feshie/ms1/SystemBlock.png

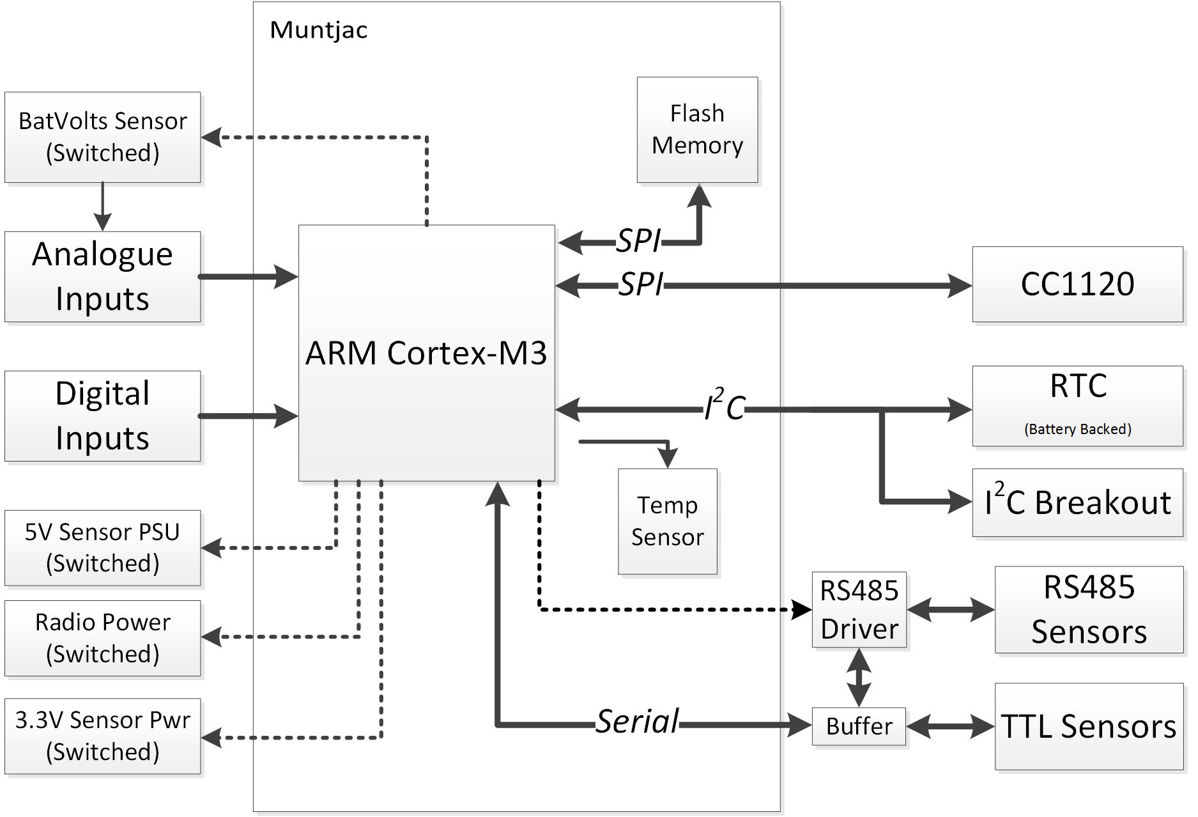
SystemBlock.png
