feshie/ms1/ms1.brd

## EAGLE design ms1.brd (2014-09-29)

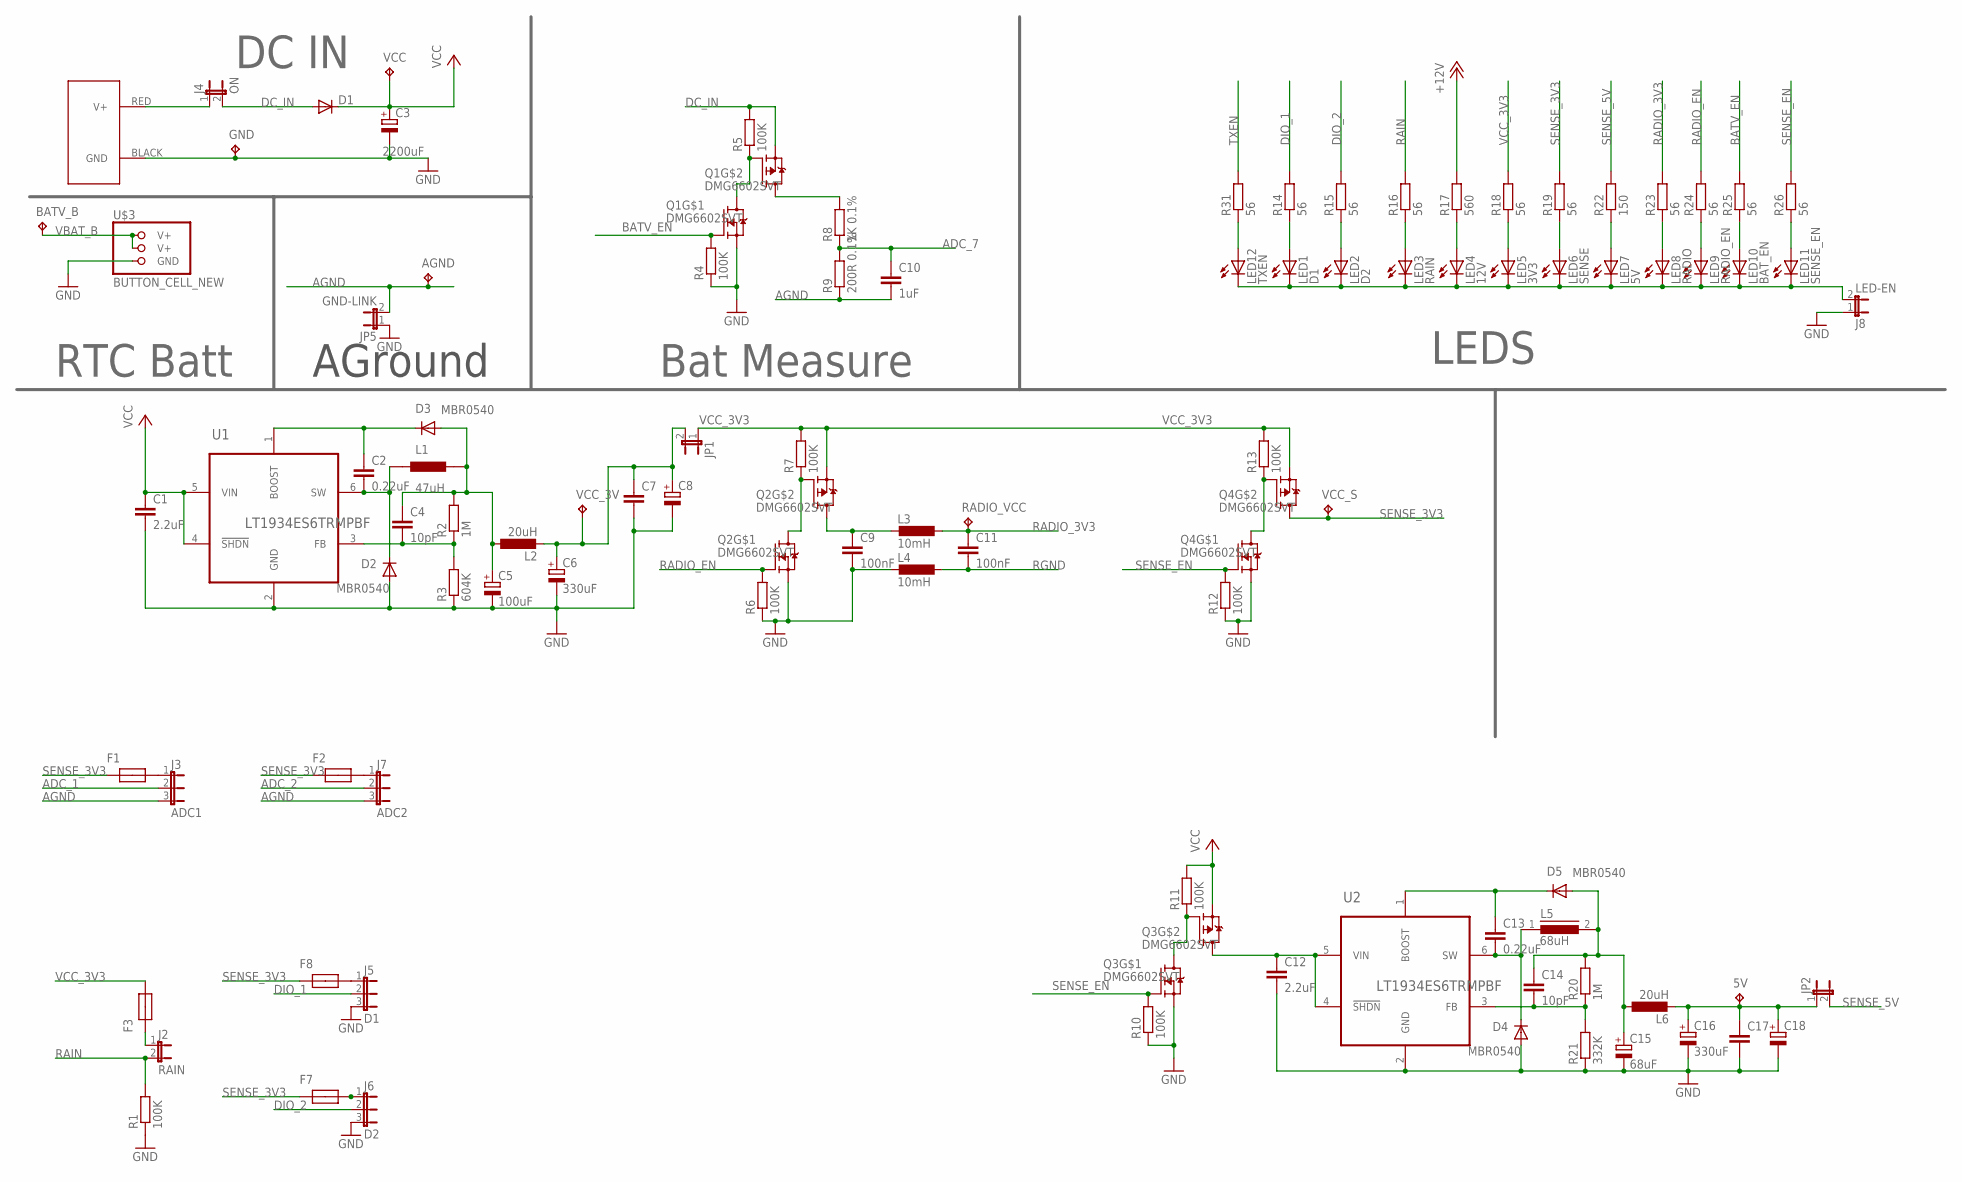
[picture p2: schematic ms1.sch, sheet 1, Power]

Parts:
5V: 5V B; B2,54
AGND: TPB2,54; B2,54
BATV_B: 5V B; B2,54
C1, C12: 2.2uF; C0805
C2, C13: 0.22uF; C0805
C3: 2200uF; E5-13
C4, C14: 10pF; C0805
C5: 100uF; PANASONIC_E
C6, C16: 330uF; E5-8,5
C7, C17: C-EUC0805; C0805
C8, C18: CPOL-EUB/3528-21R; B/3528-21R
C9, C11: 100nF; C0805
C10: 1uF; C0805
C15: 68uF; PANASONIC_E
D1: DIODE-SMB; SMB
D2, D3, D4, D5: MBR0540; SOD123
F1, F2, F3, F7, F8: MCF0805; 0805
GND: 5V B; B2,54
J1: POWERPOLE_POWER25A; POWERPOLE_PAIR_25A
J2: RAIN; 2-MOLEX
J3: ADC1; 3-MOLEX
J4: ON; 2-MOLEX
J5: D1; 3-MOLEX
J6: D2; 3-MOLEX
J7: ADC2; 3-MOLEX
J8: LED-EN; 2-MOLEX
JP1, JP2: JUMPER-2SMD-NO; SJ_2S-NO
JP5: GND-LINK; JP1
L1: 47uH; 1048
L2, L6: 20uH; 6000-XXXX-RC
L3, L4: 10mH; L3230M
L5: 68uH; DR127
LED1: D1; CHIP-LED0805
LED2: D2; CHIP-LED0805
LED3: RAIN; CHIP-LED0805
LED4: 12V; CHIP-LED0805
LED5: 3V3; CHIP-LED0805
LED6: SENSE; CHIP-LED0805
LED7: 5V; CHIP-LED0805
LED8: RADIO; CHIP-LED0805
LED9: RADIO_EN; CHIP-LED0805
LED10: BAT_EN; CHIP-LED0805
LED11: SENSE_EN; CHIP-LED0805
LED12: TXEN; CHIP-LED0805
Q1, Q2, Q3, Q4: DMG6602SVT; TSOT26
R1, R4, R5, R6, R7, R10, R11, R12, R13: 100K; R0805
R2, R20: 1M; R0805
R3: 604K; R0805
R8: 1K 0.1%; R0805
R9: 200R 0.1%; R0805
R14, R15, R16, R18, R19, R23, R24, R25, R26, R31: 56; R0805
R17: 560; R0805
R21: 332K; R0805
R22: 150; R0805
RADIO_VCC: TPB2,54; B2,54
U1, U2: LT1934ES6TRMPBF; SOT95P280X100-6N
U$3: BUTTON_CELL_NEW; CR2016
VCC: TPB2,54; B2,54
VCC_3V: TPB2,54; B2,54
VCC_S: TPB2,54; B2,54

Connections:
ADC_1: J3.2; also elsewhere on the board
ADC_2: J7.2; also elsewhere on the board
ADC_7: C10.1, R8.1, R9.2; also elsewhere on the board
AGND: AGND.TP, C10.2, J3.3, J7.3, JP5.2, R9.1; also elsewhere on the board
BATV_EN: Q1.P$1 (G), R4.2, R25.2; also elsewhere on the board
DC_IN: D1.A, J4.2, Q1.P$2 (S), R5.2
DIO_1: J5.2, R14.2; also elsewhere on the board
DIO_2: J6.2, R15.2; also elsewhere on the board
GND: C1.2, C3.-, C5.-, C6.-, C7.2, C8.-, C9.2, C12.2, C15.-, C16.-, C17.2, C18.-, D2.A, D4.A, GND.TP, J1.BLACK (GND), J5.3, J6.3, J8.1, JP5.1, L4.2, Q1.P$5 (S), Q2.P$5 (S), Q3.P$5 (S), Q4.P$5 (S), R1.1, R3.1, R4.1, R6.1, R10.1, R12.1, R21.1, U1.2 (GND), U2.2 (GND), U$3.GND; also elsewhere on the board
LGND: J8.2, LED1.C, LED2.C, LED3.C, LED4.C, LED5.C, LED6.C, LED7.C, LED8.C, LED9.C, LED10.C, LED11.C, LED12.C
unnamed: J1.RED (V+), J4.1
unnamed: LED4.A, R17.1
unnamed: C13.2, D4.C, L5.1, U2.6 (SW)
unnamed: C13.1, D5.C, U2.1 (BOOST)
unnamed: C14.2, R20.1, R21.2, U2.3 (FB)
unnamed: C14.1, C15.+, D5.A, L5.2, L6.1, R20.2
unnamed: Q2.P$3 (G), Q2.P$6 (D), R7.1
unnamed: Q1.P$3 (G), Q1.P$6 (D), R5.1
unnamed: C6.+, C7.1, C8.+, JP1.2, L2.2, VCC_3V.TP
unnamed: 5V.TP, C16.+, C17.1, C18.+, JP2.1, L6.2
unnamed: LED9.A, R24.1
unnamed: LED3.A, R16.1
unnamed: F1.2, J3.1
unnamed: F2.2, J7.1
unnamed: LED2.A, R15.1
unnamed: F7.2, J6.1
unnamed: F8.2, J5.1
unnamed: LED1.A, R14.1
unnamed: C9.1, L3.2, Q2.P$4 (D)
unnamed: Q3.P$3 (G), Q3.P$6 (D), R11.1
unnamed: F3.1, J2.1
unnamed: LED12.A, R31.1
unnamed: LED10.A, R25.1
unnamed: LED11.A, R26.1
unnamed: Q4.P$3 (G), Q4.P$6 (D), R13.1
unnamed: C2.2, D2.C, L1.1, U1.6 (SW)
unnamed: C4.1, C5.+, D3.A, L1.2, L2.1, R2.2
unnamed: LED8.A, R23.1
unnamed: LED7.A, R22.1
unnamed: LED6.A, R19.1
unnamed: LED5.A, R18.1
unnamed: C2.1, D3.C, U1.1 (BOOST)
unnamed: C4.2, R2.1, R3.2, U1.3 (FB)
RADIO_3V3: C11.1, L3.1, R23.2, RADIO_VCC.TP; also elsewhere on the board
RADIO_EN: Q2.P$1 (G), R6.2, R24.2; also elsewhere on the board
RAIN: J2.2, R1.2, R16.2; also elsewhere on the board
RGND: C11.2, L4.1; also elsewhere on the board
SENSE_3V3: F1.1, F2.1, F7.1, F8.1, Q4.P$4 (D), R19.2, VCC_S.TP; also elsewhere on the board
SENSE_5V: JP2.2, R22.2; also elsewhere on the board
SENSE_EN: Q3.P$1 (G), Q4.P$1 (G), R10.2, R12.2, R26.2; also elsewhere on the board
TXEN: R31.2; also elsewhere on the board
VBAT_B: BATV_B.TP, U$3.V+@1 (V+), U$3.V+@2 (V+); also elsewhere on the board
VCC: C1.1, C3.+, D1.C, Q3.P$2 (S), R11.2, R17.2, U1.4 (!SHDN), U1.5 (VIN), VCC.TP
VCC_3V3: F3.2, JP1.1, Q2.P$2 (S), Q4.P$2 (S), R7.2, R13.2, R18.2; also elsewhere on the board
VCC_HP2_SW: C12.1, Q3.P$4 (D), U2.4 (!SHDN), U2.5 (VIN)
VCC_HP2_SW1: Q1.P$4 (D), R8.2

Notes on the sheet:
LEDS
DC IN
Bat Measure
RTC Batt
AGround

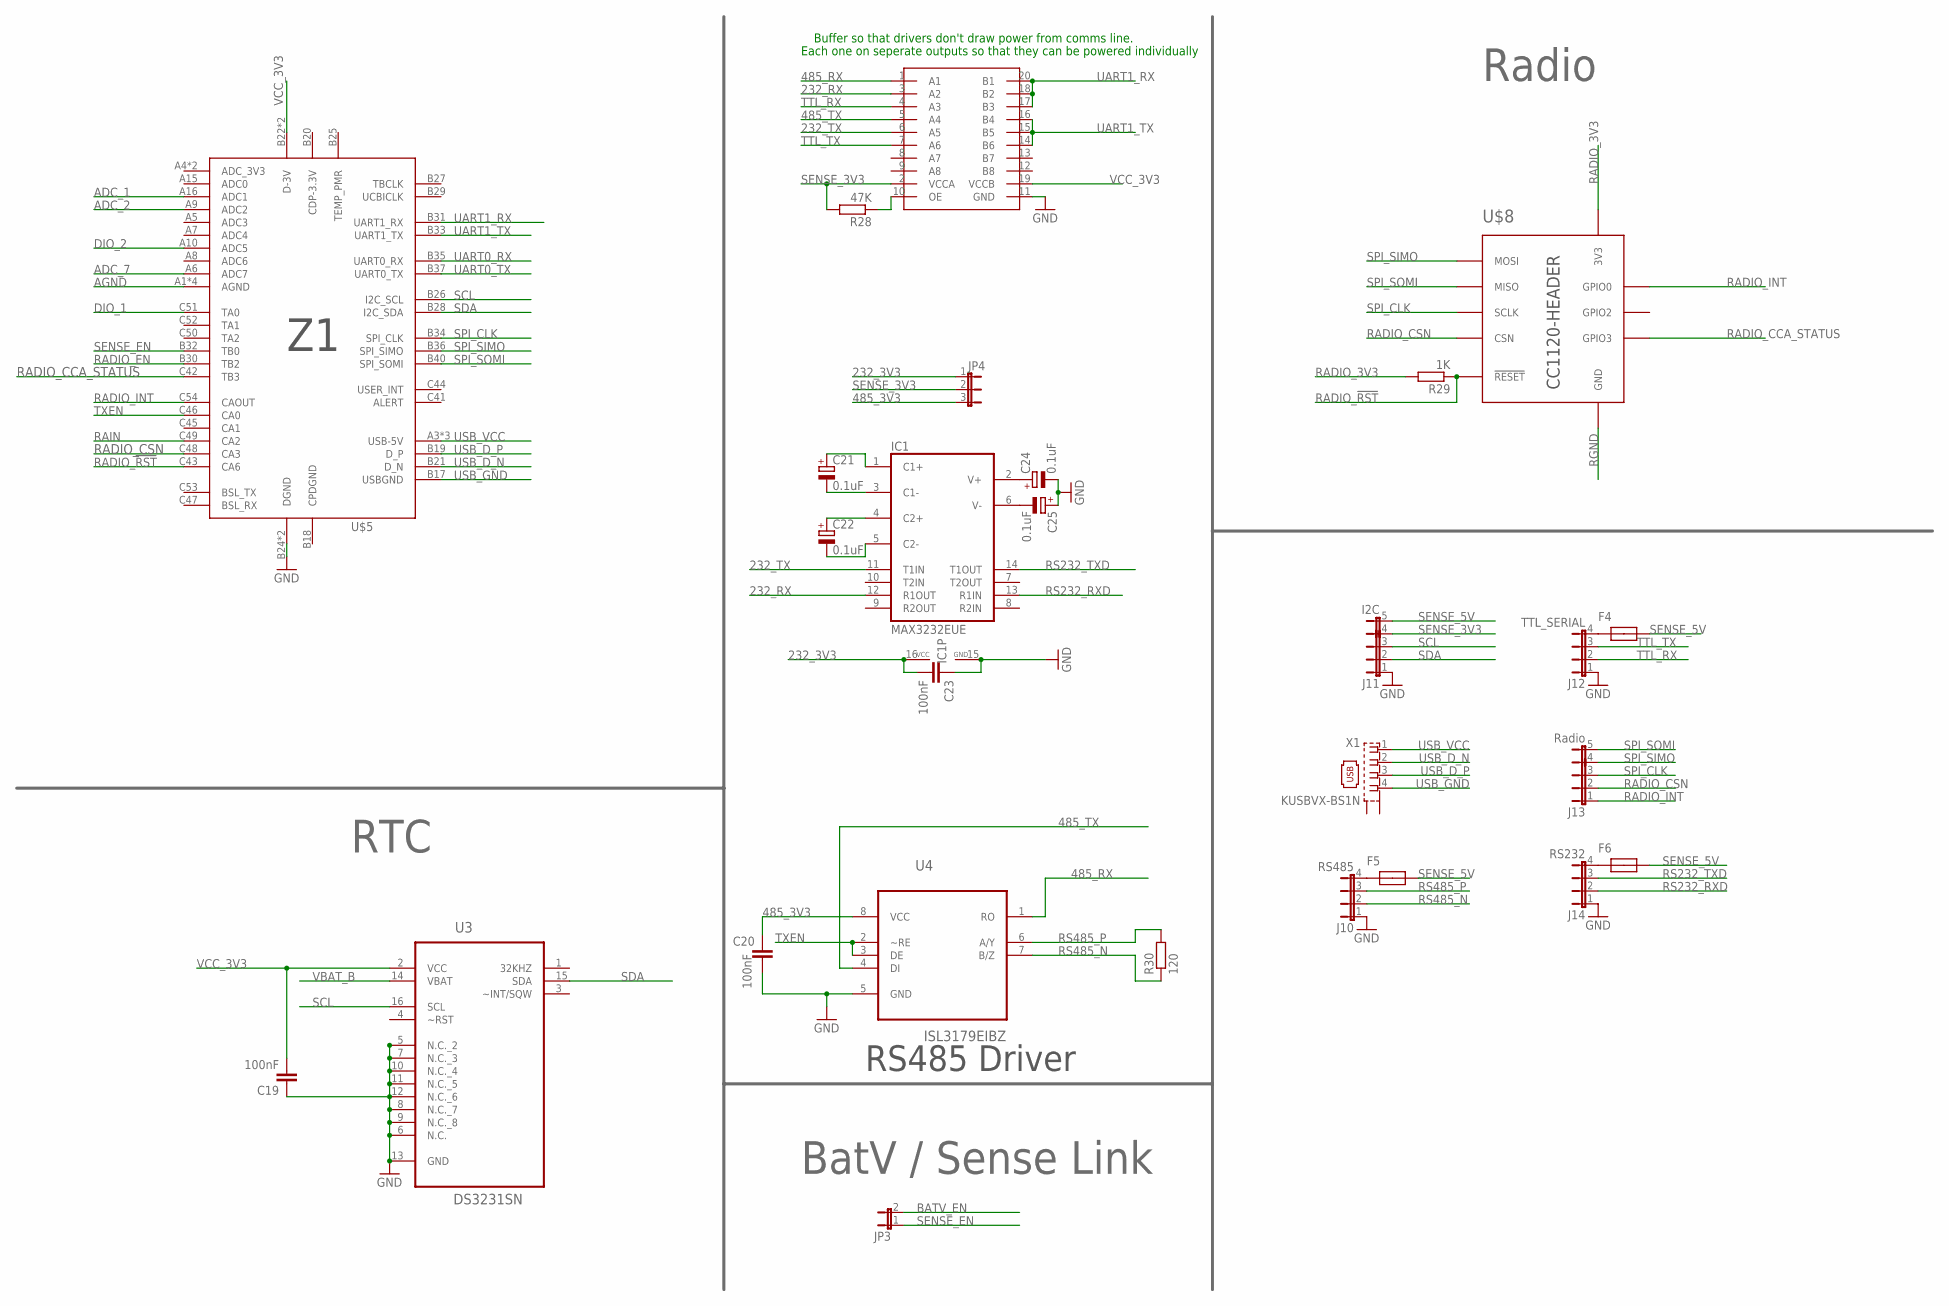
[picture p3: schematic ms1.sch, sheet 2, ICs]

Parts:
C19, C20, C23: 100nF; C0805
C21, C22, C24, C25: 0.1uF; A/3216-18W
F4, F5, F6: MCF0805; 0805
IC1: MAX3232EUE; TSSOP16
J10: RS485; 4-MOLEX
J11: I2C; 5-MOLEX
J12: TTL_SERIAL; 4-MOLEX
J13: Radio; 5-MOLEX
J14: RS232; 4-MOLEX
JP3: JUMPER-2SMD-NC; SJ_2S
JP4: JP2E; JP2
R28: 47K; R0805
R29: 1K; R0805
R30: 120; R0805
U3: DS3231SN; SOIC127P1032X265-16N
U4: ISL3179EIBZ; SOIC127P600X175-8N
U$5: Z1
U$6: TXS0108E; TSSOP20
U$8: CC1120-HEADER-SMT; CC1120-HEADERS-SMT
X1: KUSBVX-BS1N

Connections:
232_3V3: C23.2, IC1.16 (VCC), JP4.1
232_RX: IC1.12 (R1OUT), U$6.3 (A2)
232_TX: IC1.11 (T1IN), U$6.6 (A5)
485_3V3: C20.1, JP4.3, U4.8 (VCC)
485_RX: U4.1 (RO), U$6.1 (A1)
485_TX: U4.4 (DI), U$6.5 (A4)
ADC_1: U$5.A16 (ADC1); also elsewhere on the board
ADC_2: U$5.A9 (ADC2); also elsewhere on the board
ADC_3V3: U$5.A4 (ADC_3V3), U$5.A14 (ADC_3V3)
ADC_7: U$5.A6 (ADC7); also elsewhere on the board
AGND: U$5.A1 (AGND), U$5.A2 (AGND), U$5.A11 (AGND), U$5.A12 (AGND); also elsewhere on the board
BATV_EN: JP3.2; also elsewhere on the board
DIO_1: U$5.C51 (TA0); also elsewhere on the board
DIO_2: U$5.A10 (ADC5); also elsewhere on the board
GND: C19.1, C20.2, C23.1, C24.-, C25.+, IC1.15 (GND), J10.1, J11.1, J12.1, J14.1, U3.5 (N.C._2), U3.6 (N.C.), U3.7 (N.C._3), U3.8 (N.C._7), U3.9 (N.C._8), U3.10 (N.C._4), U3.11 (N.C._5), U3.12 (N.C._6), U3.13 (GND), U4.5 (GND), U$5.B24 (DGND), U$5.C39 (DGND), U$6.11 (GND); also elsewhere on the board
unnamed: R28.1, U$6.10 (OE)
unnamed: F5.1, J10.4
unnamed: F4.1, J12.4
unnamed: F6.1, J14.4
unnamed: C22.-, IC1.5 (C2-)
unnamed: C22.+, IC1.4 (C2+)
unnamed: C21.-, IC1.3 (C1-)
unnamed: C21.+, IC1.1 (C1+)
unnamed: C24.+, IC1.2 (V+)
unnamed: C25.-, IC1.6 (V-)
RADIO_3V3: R29.2, U$8.3V3-1 (3V3), U$8.3V3-2 (3V3); also elsewhere on the board
RADIO_!RST: R29.1, U$5.C43 (CA6), U$8.RESET (!RESET)
RADIO_CCA_STATUS: U$5.C42 (TB3), U$8.GPIO3
RADIO_CSN: J13.2, U$5.C48 (CA3), U$8.CSN
RADIO_EN: U$5.B30 (TB2); also elsewhere on the board
RADIO_INT: J13.1, U$5.C54 (CAOUT), U$8.GPIO0
RAIN: U$5.C49 (CA2); also elsewhere on the board
RGND: U$8.GND, U$8.GND1 (GND), U$8.GND2 (GND); also elsewhere on the board
RS232_RXD: IC1.13 (R1IN), J14.2
RS232_TXD: IC1.14 (T1OUT), J14.3
RS485_N: J10.2, R30.1, U4.7 (B/Z)
RS485_P: J10.3, R30.2, U4.6 (A/Y)
SCL: J11.3, U3.16 (SCL), U$5.B26 (I2C_SCL)
SDA: J11.2, U3.15 (SDA), U$5.B28 (I2C_SDA)
SENSE_3V3: J11.4, JP4.2, R28.2, U$6.2 (VCCA); also elsewhere on the board
SENSE_5V: F4.2, F5.2, F6.2, J11.5 (6); also elsewhere on the board
SENSE_EN: JP3.1, U$5.B32 (TB0); also elsewhere on the board
SPI_CLK: J13.3, U$5.B34 (SPI_CLK), U$8.SCLK
SPI_SIMO: J13.4, U$5.B36 (SPI_SIMO), U$8.MOSI
SPI_SOMI: J13.5 (6), U$5.B40 (SPI_SOMI), U$8.MISO
TTL_RX: J12.2, U$6.4 (A3)
TTL_TX: J12.3, U$6.7 (A6)
TXEN: U4.2 (~RE), U4.3 (DE), U$5.C46 (CA0); also elsewhere on the board
UART0_RX: U$5.B35 (UART0_RX)
UART0_TX: U$5.B37 (UART0_TX)
UART1_RX: U$5.B31 (UART1_RX), U$6.17 (B3), U$6.18 (B2), U$6.20 (B1)
UART1_TX: U$5.B33 (UART1_TX), U$6.14 (B6), U$6.15 (B5), U$6.16 (B4)
USB_D_N: U$5.B21 (D_N), X1.2
USB_D_P: U$5.B19 (D_P), X1.3
USB_GND: U$5.B17 (USBGND), X1.4
USB_VCC: U$5.A3 (USB-5V), U$5.A13 (USB-5V), U$5.B23 (USB-5V), X1.1
VBAT_B: U3.14 (VBAT); also elsewhere on the board
VCC_3V3: C19.2, U3.2 (VCC), U$5.B22 (D-3V), U$5.C40 (D-3V), U$6.19 (VCCB); also elsewhere on the board

Notes on the sheet:
RTC
Radio
BatV / Sense Link
RS485 Driver
Buffer so that drivers don't draw power from comms line.
Each one on seperate outputs so that they can be powered individually

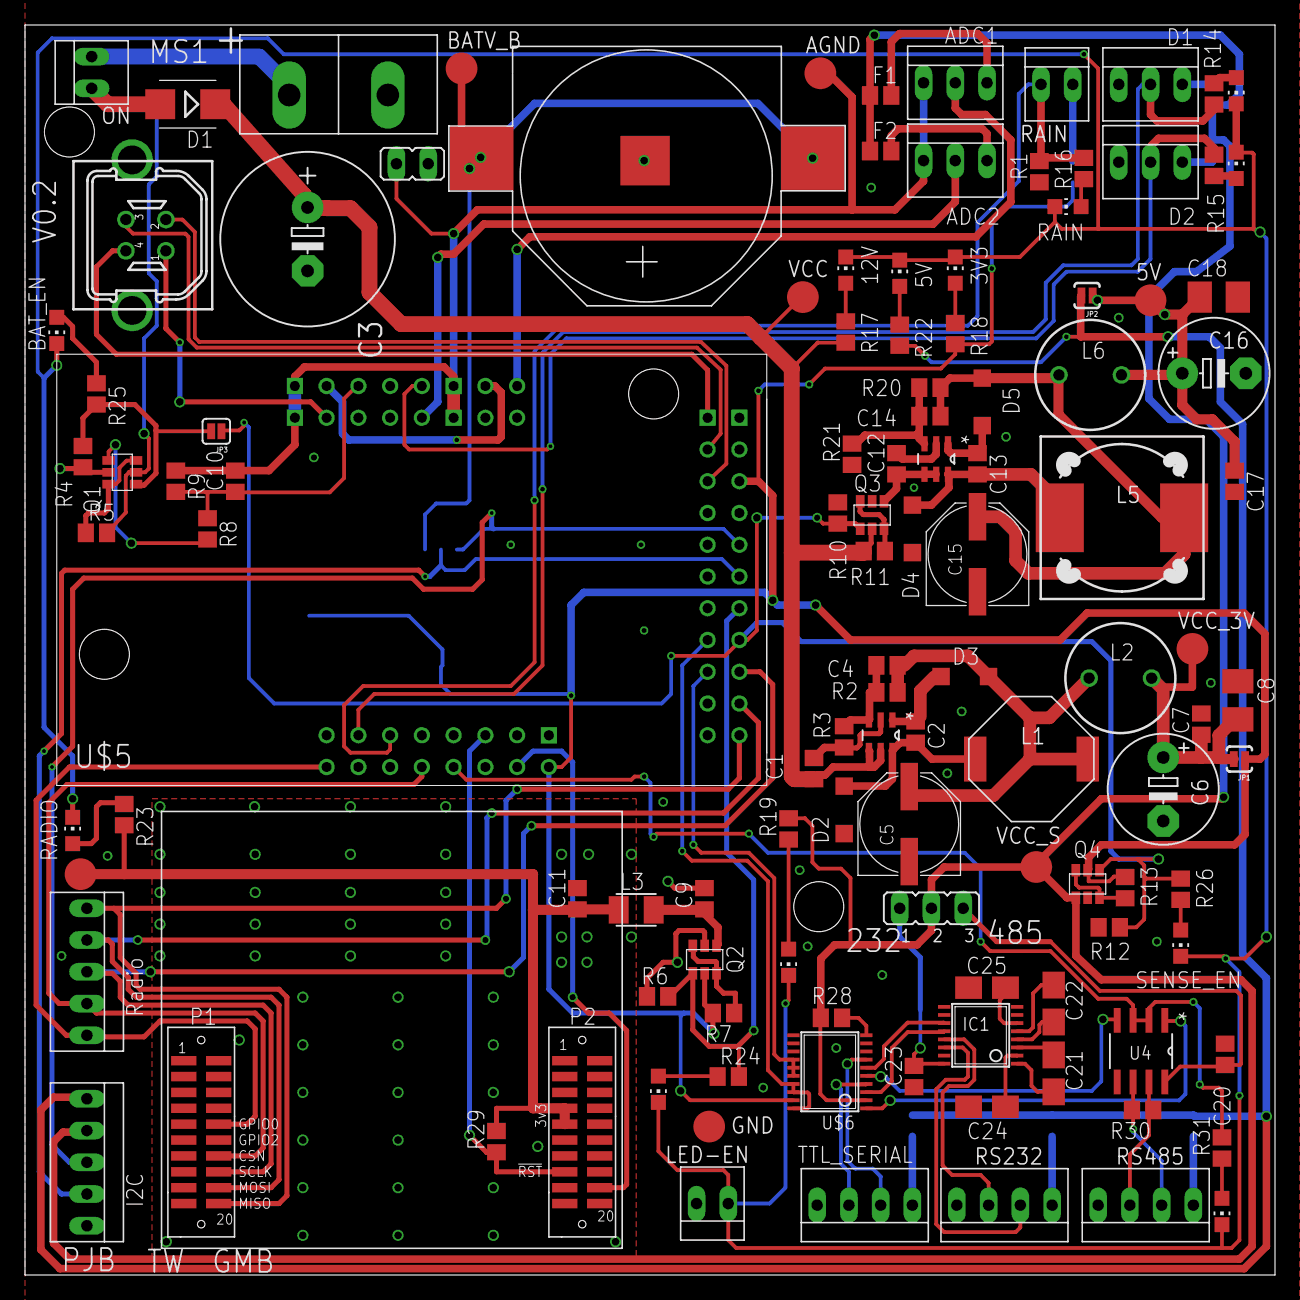
[picture p4: board ms1.brd from above]

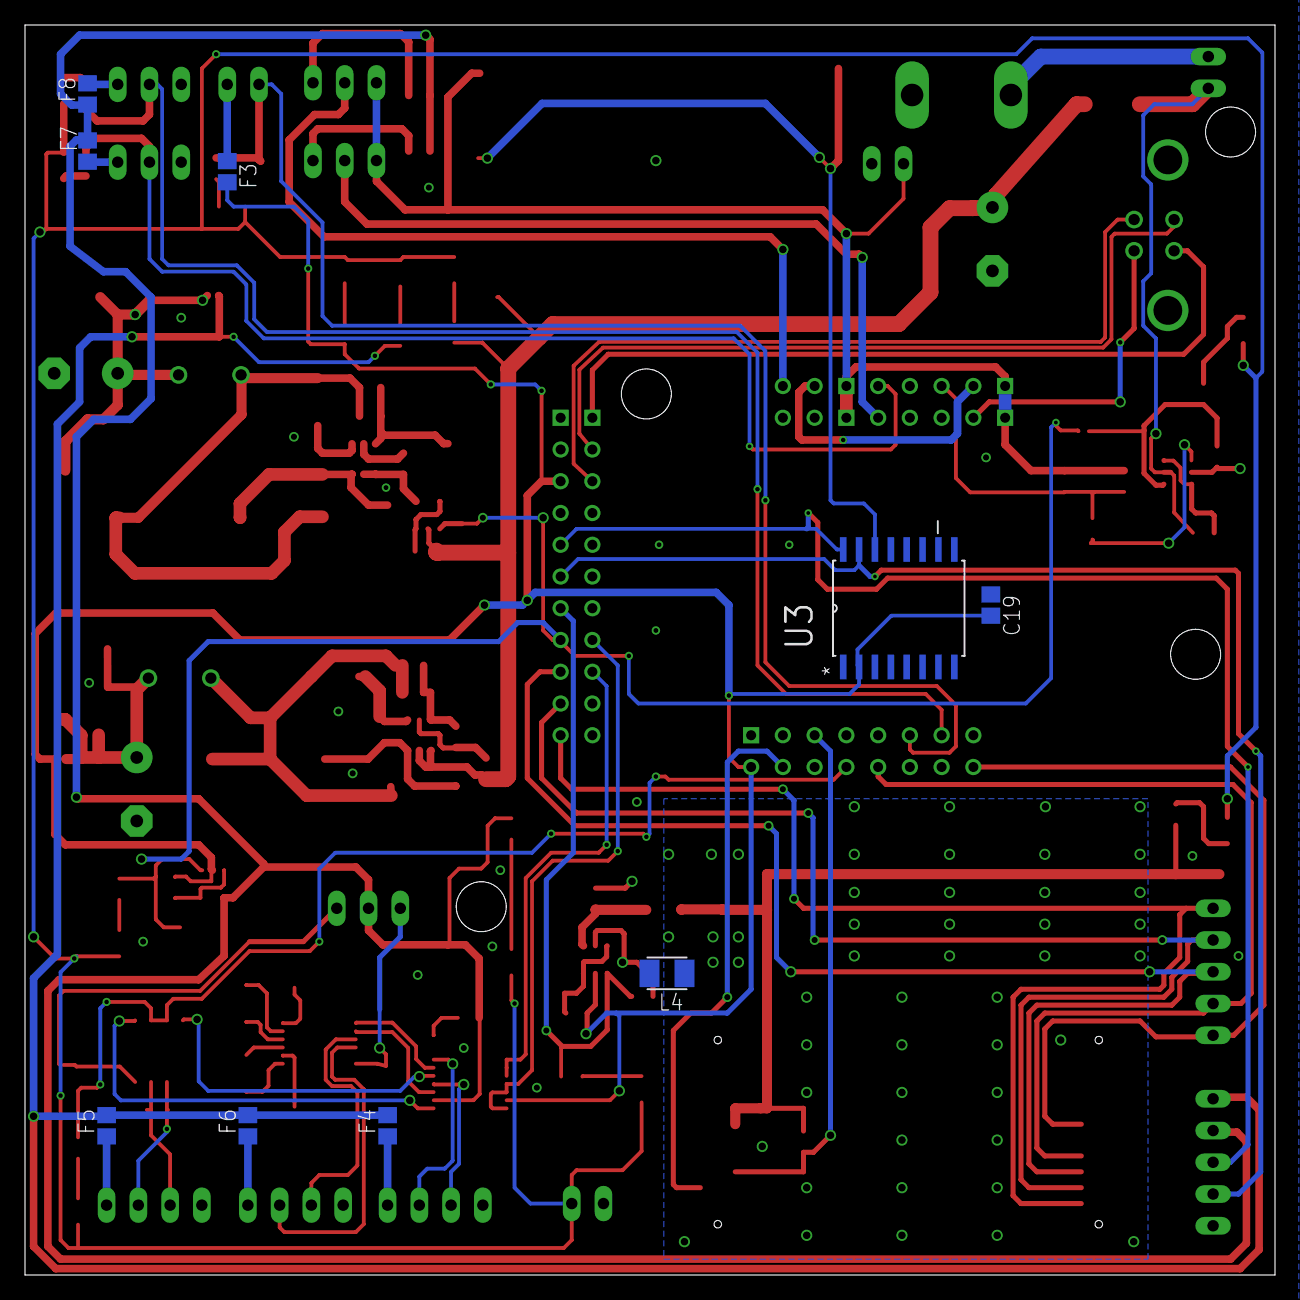
[picture p5: board ms1.brd from below]

Board: 2 copper layers, 100.0 x 100.0 mm, 126 parts (9 on the bottom side), 94 nets.
