feshie/ms1/(commit log)

2014-05-02 First bits of design for node
    [ms1.sch]
2014-05-02 rtc added
    [ms1.sch]
2014-05-06 Added waspmote part & cc1120 added vbat measure added radio switched power started to add connectors
    [ms1.sch]
2014-05-09 started to connect things up
    [ms1.sch]
2014-05-09 added headers for I/O tidying up schematic added SPI to wasp
    [ms1.sch]
2014-05-09 finsihed boxing fixed a couple of ERC errors reduced to one page now smd input protection diode
    [ms1.sch]
2014-05-10 filtering for radio vcc inductor removed for AGND as it's on Z1 ERC checking performed
    [ms1.sch]
2014-05-10 start of PCB layout
    [ms1.brd, ms1.sch]
2014-05-12 a little more routing
    [ms1.brd]
2014-05-12 power supplies mostly routed
    [ms1.brd, ms1.sch]
2014-05-13 serial stuff laid out
    [ms1.brd, ms1.sch]
2014-05-23 added pullup to !RESET on CC1120
    [ms1.brd, ms1.sch]
2014-05-26 added reset link from cc1120 to msp
    [ms1.brd, ms1.sch]
2014-05-27 cc1120 wiring matches test harness
    [ms1.brd, ms1.sch]
2014-05-31 now has cca pin
    [ms1.brd, ms1.sch]
2014-06-02 routed GPIO3
    [ms1.brd]
2014-06-05 now uses dr127 for 5w inductor
    [ms1.brd, ms1.sch]
2014-06-05 more smoothing to 5v rail
    [ms1.brd, ms1.sch]
2014-06-08 more smoothing on 3v3 output
    [ms1.brd, ms1.sch]
2014-06-17 minor routing changes
    [ms1.brd]
2014-06-17 more routing - mainly digital signals
    [ms1.brd, ms1.sch]
2014-06-18 removal of libellium part
    [ms1.brd, ms1.sch]
2014-06-18 now uses correct serial buffer
    [ms1.brd, ms1.sch]
2014-06-18 now has: * rain gauge input * 2 digital io * 2 analog io * poly fuses
    [ms1.brd, ms1.sch]
2014-06-18 now all routed :)
    [ms1.brd, ms1.sch]
2014-06-19 A couple of small bugfixes
    Moved battery + away from battery negative terminal
    moved clearance issue via
    [ms1.brd]
2014-06-19 silk screen worked
    [ms1.brd, ms1.sch]
2014-06-23 As submitted to hackvana
    [ms1.brd, ms1.sch]
2014-09-02 fixes #2 now has rs483 termination resistor
    [ms1.brd, ms1.sch]
2014-09-02 fixes #7 now has gnd link header
    [ms1.brd, ms1.sch]
2014-09-02 fixes #4 all the same pins on z1 are now linked
    [ms1.brd, ms1.sch]
2014-09-02 DIO remapped to be TXEN for rs485, new DIO pin not yet selected
    [ms1.brd, ms1.sch]
2014-09-04 Fixes #1 DIO_2 now on ADC5 which can be used for digital IO, and the hack permenantly routed to rs485 driver
    [ms1.brd, ms1.sch]
2014-09-29 now with correct values for batv divider
    [ms1.brd, ms1.sch]
